Kazu-zamasu/1114FN28-Kids-Shiled/BOM.md

不明なものは飛ばしてます。値段は1枚あたりの単品価格。価格は秋月価格

1.実装部品
1)ピンヘッダ　1-40 40円  
http://akizukidenshi.com/catalog/g/gC-00167/  
2)半固定ボリューム 0-100kΩ 50円  
http://akizukidenshi.com/catalog/g/gP-06113/  
3)フォトICダイオードS9648-100 120円×2  
http://akizukidenshi.com/catalog/g/gI-02426/  
4)抵抗内蔵5mm赤色LED（5V用）OSR6LU5B64A-5V (10個入) 120円 1つあたり12円 赤・緑・黄色は価格同じなので36円  
http://akizukidenshi.com/catalog/g/gI-06245/  
5)抵抗内蔵5mm青色LED（5V用）OSB5SA5B64A-5V (10個入) 200円 1つあたり20円 青  
http://akizukidenshi.com/catalog/g/gI-06247/  
6)サーミスタ 10kΩ（ラジアルリードタイプ）50円 2個 100円  
http://akizukidenshi.com/catalog/g/gP-07258/  
7)POWER MOS-FET 駆動電圧は1-5V位の？ 大体1つ100円 2個 200円  
参考URL http://akizukidenshi.com/catalog/g/gI-02414/  
8)その他RCLで２０個位？（そこまでは要らん気するけどｗ）で５円×２０で１００円？  

基板実装費とあとは制作費、発送料とか振込手数料は別途。袋詰とか印刷費とか別途で。追加あればバンバンよろしく。  
ここまでの合計金額は  
  
７８６円です.  

追加1  
1-1)ターミナルブロック　2ピン（緑）（縦）小  20円 × ２個  40円  
http://akizukidenshi.com/catalog/g/gP-02333/  
1-2)電池ボックス　単３×２本　プラスチック　ピン付 40円  
http://akizukidenshi.com/catalog/g/gP-03086/  
ここで866円  

追加2  
2-1)タクトスイッチ（赤色・黒色）各１つづつ 10円×2個 20円  
http://akizukidenshi.com/catalog/g/gP-03646/  
2-2)トグルスイッチ1回路2接点（ON-ONタイプ 80円  
http://akizukidenshi.com/catalog/g/gP-03774/  
2-3)トグルスイッチ2回路2接点（ON－OFF－ONタイプ）中点OFF 100円  
http://akizukidenshi.com/catalog/g/gP-07399/  

ここで、1066円  

変更1    
4)抵抗内蔵5mm赤色LED（5V用）OSR6LU5B64A-5V (10個入) 120円 1つあたり12円 赤・緑・黄色は価格同じなので36円  
http://akizukidenshi.com/catalog/g/gI-06245/  
5)抵抗内蔵5mm青色LED（5V用）OSB5SA5B64A-5V (10個入) 200円 1つあたり20円 青  
http://akizukidenshi.com/catalog/g/gI-06247/  
2-2)トグルスイッチ1回路2接点（ON-ONタイプ 80円  
http://akizukidenshi.com/catalog/g/gP-03774/  
3)フォトICダイオードS9648-100 120円×2   
http://akizukidenshi.com/catalog/g/gI-02426/  
  
上記を以下に変更  
  
4)抵抗内蔵5mm赤色LED（5V用）OSR6LU5B64A-5V (10個入) 120円 1つあたり12円 赤・緑は価格同じなので24円  
http://akizukidenshi.com/catalog/g/gI-06245/  
5)RGBフルカラーLED（４本足）5mm [OSTA-5131A] (10個入) 1個50円   
http://akizukidenshi.com/catalog/g/gI-03037/  
3)フォトICダイオードS9648-100 120円×1  
http://akizukidenshi.com/catalog/g/gI-02426/  

以下削除  
2-2)トグルスイッチ1回路2接点（ON-ONタイプ 80円  
http://akizukidenshi.com/catalog/g/gP-03774/  
ここで884円  
  
##最終仕様  
1)半固定ボリューム 0-100kΩ 50円  
http://akizukidenshi.com/catalog/g/gP-06113/  
2)フォトICダイオードS9648-100 120円×1  
http://akizukidenshi.com/catalog/g/gI-02426/  
3)抵抗内蔵5mm赤色LED（5V用）OSR6LU5B64A-5V (10個入) 120円 1つあたり12円 緑は価格同じなので24円  
http://akizukidenshi.com/catalog/g/gI-06245/  
4)サーミスタ 10kΩ（ラジアルリードタイプ）50円  
http://akizukidenshi.com/catalog/g/gP-07258/  
5)タクトスイッチ（赤色・黒色）各１つづつ 10円×2個 20円  
http://akizukidenshi.com/catalog/g/gP-03646/  
6)トグルスイッチ1回路2接点（ON-ONタイプ 80円  
http://akizukidenshi.com/catalog/g/gP-03774/  
8)NchパワーMOSFET　IRFU120NPBF  50円×2 100円  
http://akizukidenshi.com/catalog/g/gI-06050/  
9)ターミナルブロック　2ピン（緑）（縦）小  20円 × ２個  40円  
http://akizukidenshi.com/catalog/g/gP-02333/  
10)ピンソケット(メス)1×8(8P) 30円  
http://akizukidenshi.com/catalog/g/gC-03785/  
11)分割ロングピンソケット 1ｘ42(42P)  80円　６個使用　11.4円   
http://akizukidenshi.com/catalog/g/gC-03785/  
12)ピンソケット(メス) 1×14 (14P) 50円 ２個使用　100円  
http://akizukidenshi.com/catalog/g/gC-00653/  
合計625.4円　その他基板作成費および実装費用

##軽微変更 
8)NchパワーMOSFET　IRFU120NPBF  50円×2 100円  
http://akizukidenshi.com/catalog/g/gI-06050/  
を以下に  
8)NchパワーMOSFET(100V17A) IRLU3410PBF 60円×2 120円  
http://akizukidenshi.com/catalog/g/gI-06025/  
合計645.4円　その他基板作成費および実装費用
