Kazu-zamasu/1114FN28-Kids-Shiled/EagleData/1114FN28-Kids-Shiled.brd

## EAGLE design EagleData/1114FN28-Kids-Shiled.brd (2015-06-10)

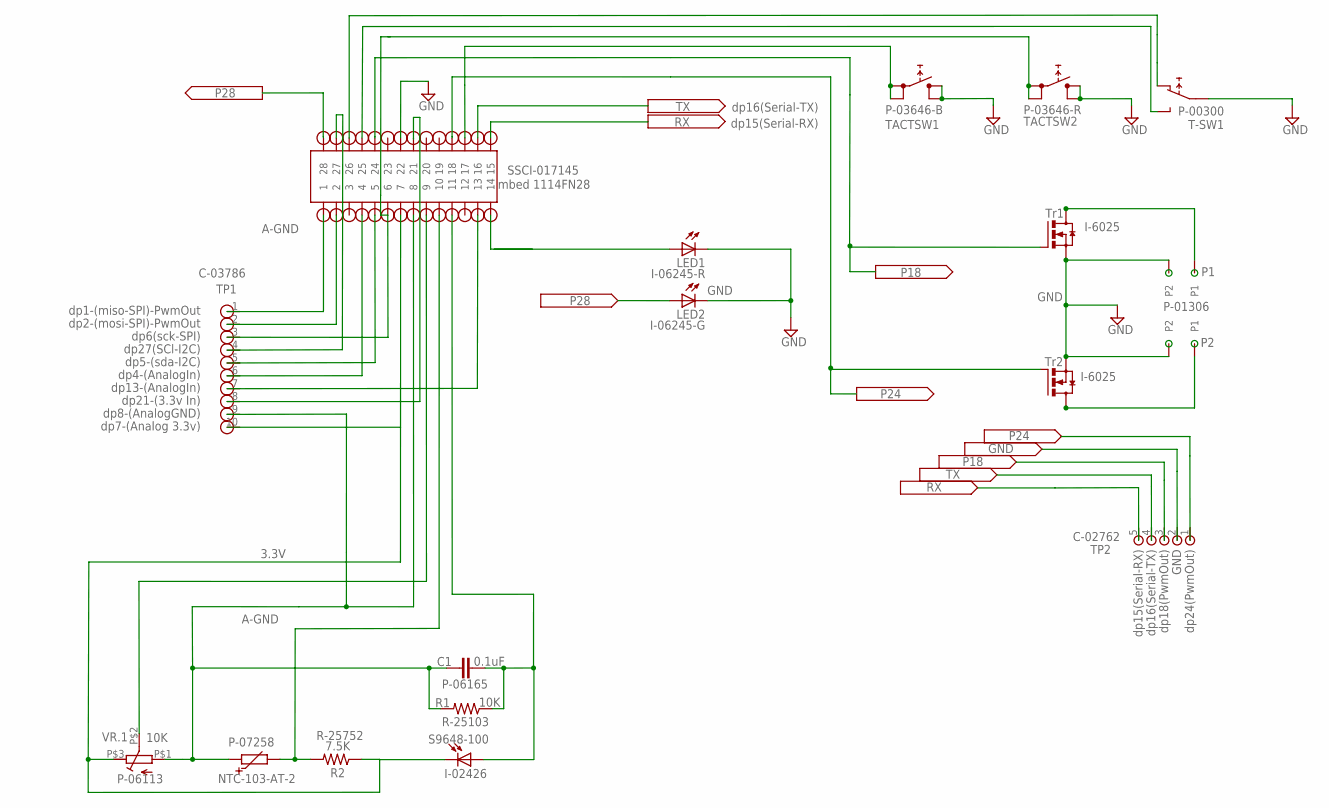
[picture p1: schematic 1114FN28-Kids-Shiled.sch]

Parts:
0-50C: NTC-103-AT-2; NTC
C1: 0.1uF; C
LED1: I-06245-R; LED5MM
LED2: I-06245-G; LED5MM
R1: 10K; R12MM
R2: 7.5K; R12MM
T-SW1: P-00300; TOGLE-SW
TACTSW1: P-03646-B; TACT-SW
TACTSW2: P-03646-R; TACT-SW
TB1, TB2: P-01306; TB
U$1: FH-1X14; DIP28-SOCKET
U$2: S9648-100; PHOTO-IC
U$3: SIPS-5
U$4, U$5: I-6025; TO251AA
U$8: SIPS-10
VR.1: 10K; VOL-TRIM

Connections:
3.3V: R2.1, U$1.P$7 (7), U$2.P$2 (C), U$8.10, VR.1.P$3 (E)
A-GND: 0-50C.1, C1.1, R1.2, U$1.P$8 (8), U$8.9, VR.1.P$1 (A)
GND: LED1.K (C), LED2.K (C), T-SW1.P$2 (2COM), TACTSW1.1 (4), TACTSW1.2, TACTSW2.1 (4), TACTSW2.2, TB1.P$2 (P2), TB2.P$2 (P2), U$1.P$22 (22), U$3.2, U$4.3 (S), U$5.3 (S)
unnamed: C1.2, R1.1, U$1.P$11 (11), U$2.P$1 (A)
unnamed: U$1.P$9 (9), VR.1.P$2 (S)
unnamed: TACTSW1.3, TACTSW1.4 (1), U$1.P$17 (17)
unnamed: U$1.P$1 (1), U$8.1
unnamed: U$1.P$5 (5), U$8.5
unnamed: U$1.P$27 (27), U$8.4
unnamed: T-SW1.P$3 (3), U$1.P$25 (25)
unnamed: U$1.P$2 (2), U$8.2
unnamed: TACTSW2.3, TACTSW2.4 (1), U$1.P$6 (6), U$8.3
unnamed: U$1.P$4 (4), U$8.6
unnamed: T-SW1.P$1 (1), U$1.P$26 (26)
unnamed: TB2.P$1 (P1), U$5.2 (D), U$5.4 (D)
unnamed: TB1.P$1 (P1), U$4.2 (D), U$4.4 (D)
unnamed: U$1.P$13 (13), U$8.7
unnamed: 0-50C.2, R2.2, U$1.P$10 (10)
unnamed: U$1.P$21 (21), U$8.8
P14: LED1.A, U$1.P$14 (14)
P18: U$1.P$18 (18), U$3.3, U$4.1 (G)
P24: U$1.P$24 (24), U$3.1, U$5.1 (G)
P28: LED2.A, U$1.P$28 (28)
RX: U$1.P$15 (15), U$3.5
TX: U$1.P$16 (16), U$3.4

Notes on the sheet:
dp13-(AnalogIn)
dp1-(miso-SPI)-PwmOut
dp2-(mosi-SPI)-PwmOut
dp6(sck-SPI)
dp27(SCl-I2C)
dp5-(sda-I2C)
dp4-(AnalogIn)
dp15(Serial-RX)
dp16(Serial-TX)
dp8-(AnalogGND)
TP1
Tr1
Tr2
mbed 1114FN28
P-01306
P-07258
P-06113
R-25103
P-06165
R-25752
I-02426
C-03786
SSCI-017145
dp21-(3.3v In)
TP2
C-02762
dp7-(Analog 3.3v)
dp24(PwmOut)
GND
dp18(PwmOut)

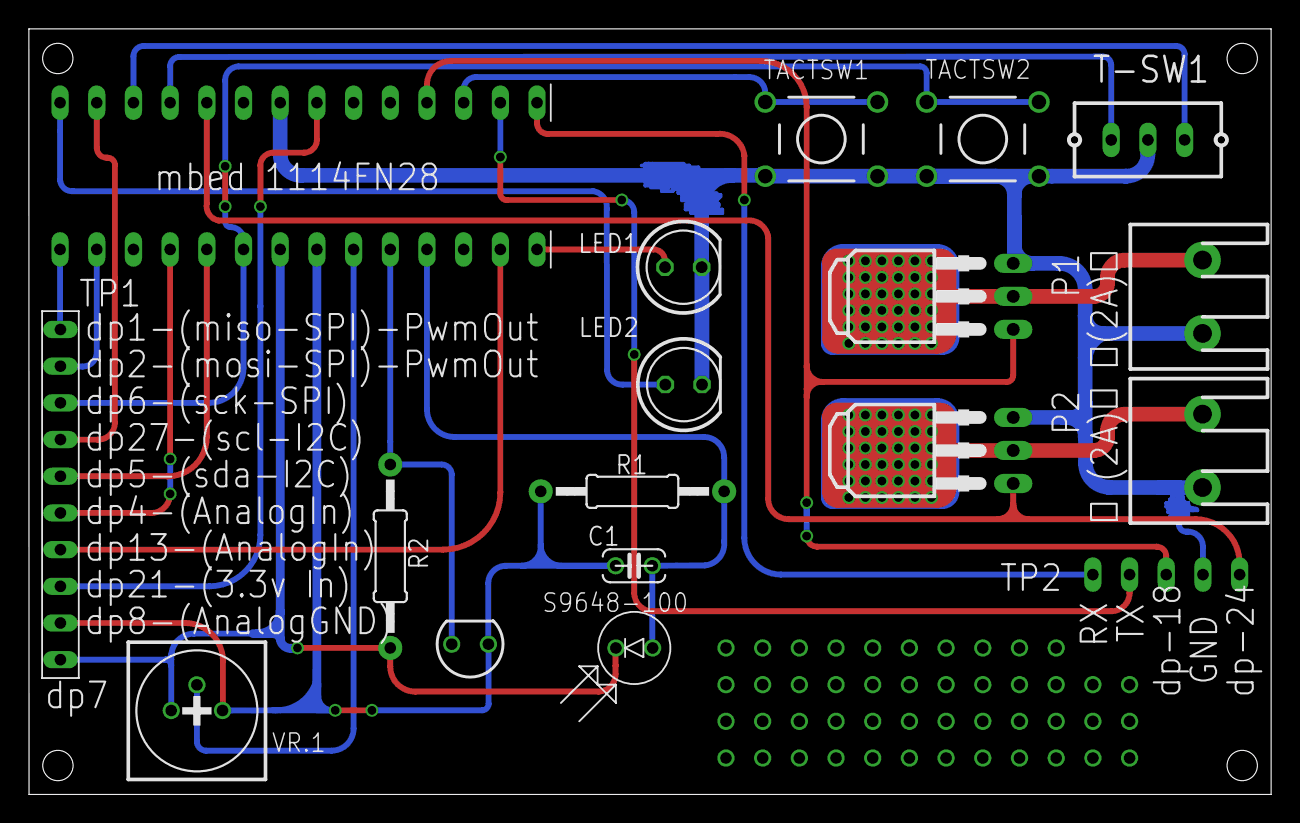
[picture p2: board 1114FN28-Kids-Shiled.brd from above]

Board: 2 copper layers, 86.0 x 53.0 mm, 19 parts (1 on the bottom side), 25 nets.

Other parts of the board:
U$7: A4L-LOC
