Kazu-zamasu/1114FN28-Kids-Shiled/(commit log)

2014-05-20 Create BOM
2014-05-20 Update BOM
2014-07-04 Eagle-data
    First-commit
    [Aruduino-Kids-Shiled.brd, Aruduino-Kids-Shiled.sch]
2014-07-04 Second
    few changes
    [Aruduino-Kids-Shiled.brd, Aruduino-Kids-Shiled.sch]
2014-07-06 Practice-Final
    Test-Build
    [Aruduino-Kids-Shiled.brd, Aruduino-Kids-Shiled.sch]
2014-07-07 Final-P-ban
    1st time
    [Aruduino-Kids-Shiled.brd, Aruduino-Kids-Shiled.sch]
2014-07-07 Test-Sample-Build
    Jet-PCB
    [Aruduino-Kids-Shiled.brd, Aruduino-Kids-Shiled.sch]
2014-07-09 Add dimensions
    [Aruduino-Kids-Shiled.brd, Aruduino-Kids-Shiled.sch]
2014-07-10 Change to Dril hole size
    2.00 to 2.1
2014-07-12 Chnge TP
    [1114FN28-Kids-Shiled.brd]
2014-07-14 Change Sch
    [1114FN28-Kids-Shiled.brd, 1114FN28-Kids-Shiled.sch]
2014-07-14 Create main.cpp
    ボード用サンプルプログラム 機能確認用
2014-07-14 First CAM
    [1114FN28-Kids-Shiled.brd, 1114FN28-Kids-Shiled.sch]
2014-07-14 Bord update
    [1114FN28-Kids-Shiled.brd]
2015-01-15 Change to FET part number.
    I-6050 to I-6025 AKIZUKI part number.
    IRLU3410PBF
    [1114FN28-Kids-Shiled.brd, 1114FN28-Kids-Shiled.sch]
2015-01-15 Change to FET
    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
2015-06-10 Rev5
    Rev5 update
    [1114FN28-Kids-Shiled.brd]
